VelianaCondor/Fluor-metro-de-bajo-costo-/Proyecto/Hito 2-Zona Procesamiento de Datos/Readme_Procesamiento_Task.md

## Aquí se verá el procesamiento de datos
## Tipos de protocolos de comunicación dentro del sistema embebido 
## La transmisión de datos (se evaluará si es con comunicación LORA o Wifi)
## El código del microcontrolador
## La interface de visualización
