VelianaCondor/Fluor-metro-de-bajo-costo-/Proyecto/Hito 2-Zona Procesamiento de Datos/Visualización en python-página web local/Diagrama de bloques .png

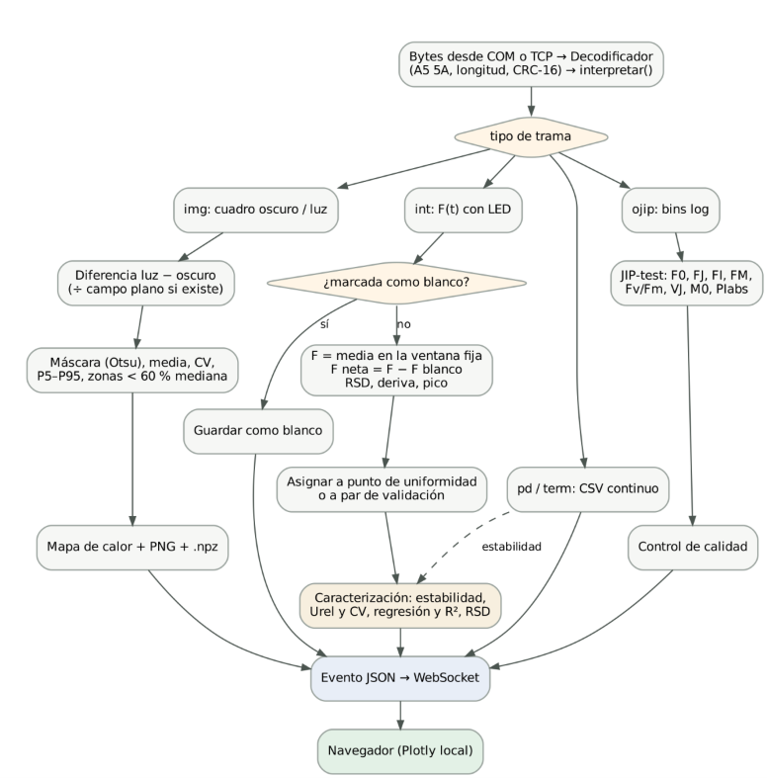
Proyecto/Hito 2-Zona Procesamiento de Datos/Visualización en python-página web local/Diagrama de bloques .png
