VelianaCondor/Fluor-metro-de-bajo-costo-/Proyecto/Hito 2/Area-optica/Diagrama-Bloques-Sistema-Optico.png

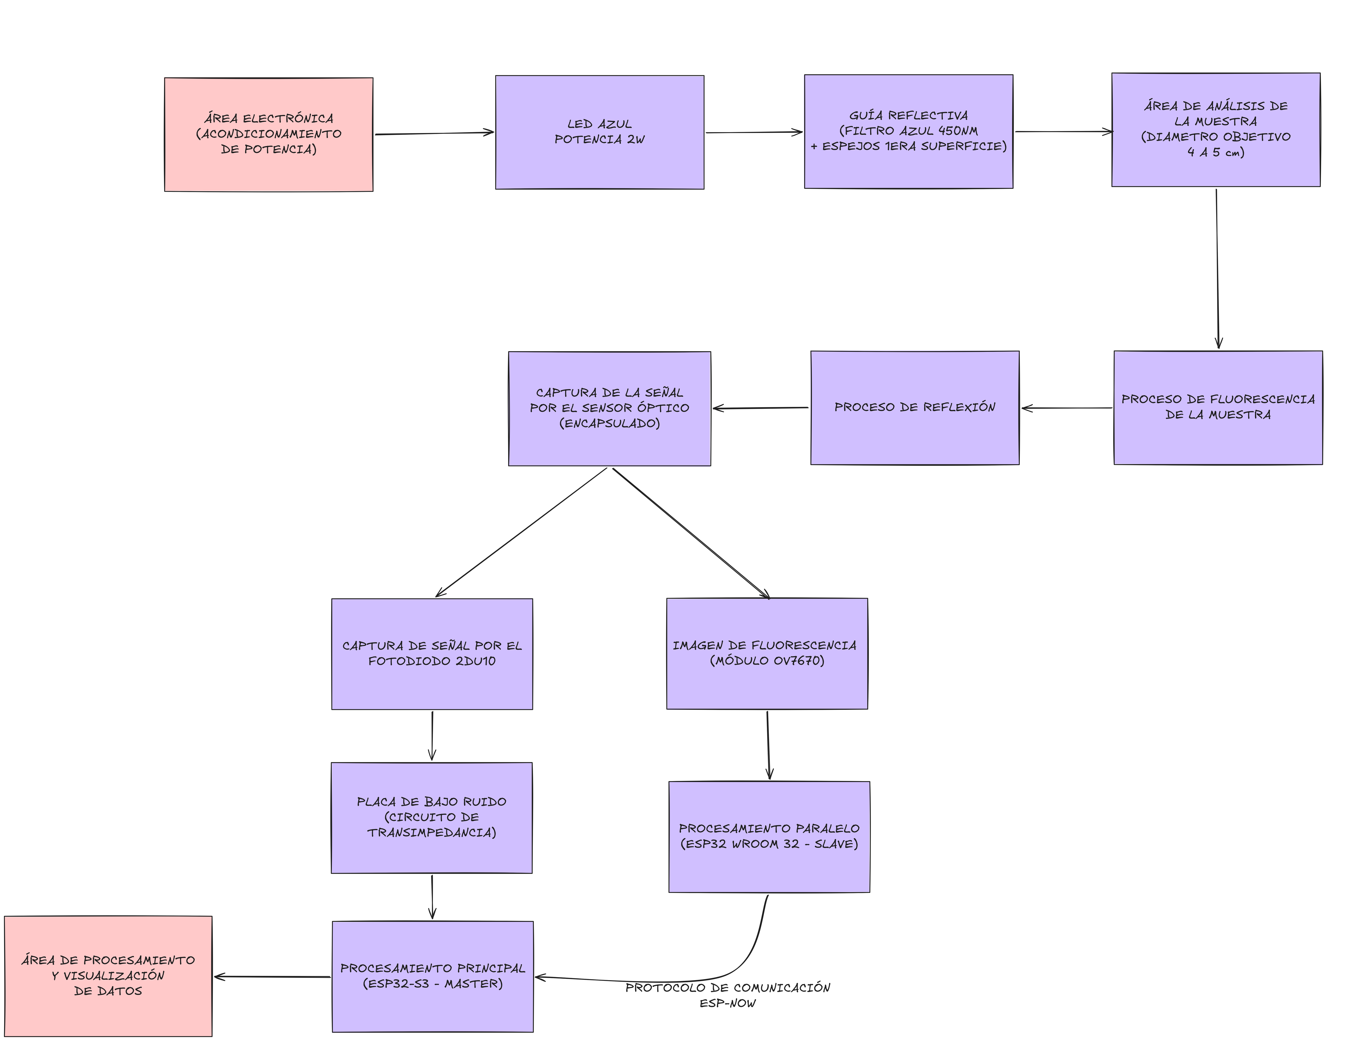
Proyecto/Hito 2/Area-optica/Diagrama-Bloques-Sistema-Optico.png
