VelianaCondor/Fluor-metro-de-bajo-costo-/Proyecto/Hito 2-Zona Procesamiento de Datos/Implementaciones preliminares (placa de bajo ruido-fotodiodo)/Data 2 fotodiodo placa.csv

No. | Date/Time | Function | Range | Value | Unit
1 | 2026-10-31 17:12:42 | DCV | 6 | 4.718 | V
2 | 2026-10-31 17:12:43 | DCV | 6 | 4.718 | V
3 | 2026-10-31 17:12:44 | DCV | 6 | 4.718 | V
4 | 2026-10-31 17:12:45 | DCV | 6 | 4.718 | V
5 | 2026-10-31 17:12:46 | DCV | 6 | 4.718 | V
6 | 2026-10-31 17:12:47 | DCV | 6 | 4.718 | V
7 | 2026-10-31 17:12:48 | DCV | 6 | 4.718 | V
8 | 2026-10-31 17:12:49 | DCV | 6 | 4.718 | V
9 | 2026-10-31 17:12:50 | DCV | 6 | 4.718 | V
10 | 2026-10-31 17:12:51 | DCV | 6 | 1.608 | V
11 | 2026-10-31 17:12:52 | DCV | 6 | 1.261 | V
12 | 2026-10-31 17:12:53 | DCV | 6 | 1.001 | V
13 | 2026-10-31 17:12:54 | DCV | 6 | 0.849 | V
14 | 2026-10-31 17:12:55 | DCV | 6 | 0.800 | V
15 | 2026-10-31 17:12:56 | DCV | 6 | 0.875 | V
16 | 2026-10-31 17:12:57 | DCV | 6 | 1.392 | V
17 | 2026-10-31 17:12:58 | DCV | 6 | 0.929 | V
18 | 2026-10-31 17:12:59 | DCV | 6 | 0.908 | V
19 | 2026-10-31 17:13:00 | DCV | 6 | 0.846 | V
20 | 2026-10-31 17:13:01 | DCV | 6 | 0.819 | V
21 | 2026-10-31 17:13:02 | DCV | 6 | 0.826 | V
22 | 2026-10-31 17:13:03 | DCV | 6 | 3.629 | V
23 | 2026-10-31 17:13:04 | DCV | 6 | 3.665 | V
24 | 2026-10-31 17:13:05 | DCV | 6 | 0.933 | V
25 | 2026-10-31 17:13:06 | DCV | 6 | 0.936 | V
26 | 2026-10-31 17:13:07 | DCV | 6 | 0.767 | V
27 | 2026-10-31 17:13:08 | DCV | 6 | 1.564 | V
28 | 2026-10-31 17:13:09 | DCV | 6 | 1.127 | V
29 | 2026-10-31 17:13:10 | DCV | 6 | 1.586 | V
30 | 2026-10-31 17:13:11 | DCV | 6 | 3.525 | V
31 | 2026-10-31 17:13:12 | DCV | 6 | 4.344 | V
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
177 | 2026-10-31 17:15:38 | DCV | 6 | -0.004 | V
178 | 2026-10-31 17:15:39 | DCV | 6 | -0.004 | V
179 | 2026-10-31 17:15:40 | DCV | 6 | -0.004 | V
180 | 2026-10-31 17:15:41 | DCV | 6 | -0.005 | V
181 | 2026-10-31 17:15:42 | DCV | 6 | -0.005 | V
182 | 2026-10-31 17:15:43 | DCV | 6 | -0.005 | V
