VelianaCondor/Fluor-metro-de-bajo-costo-/Proyecto/Hito 2 - Estructura/Ensamble Fluorometro.step

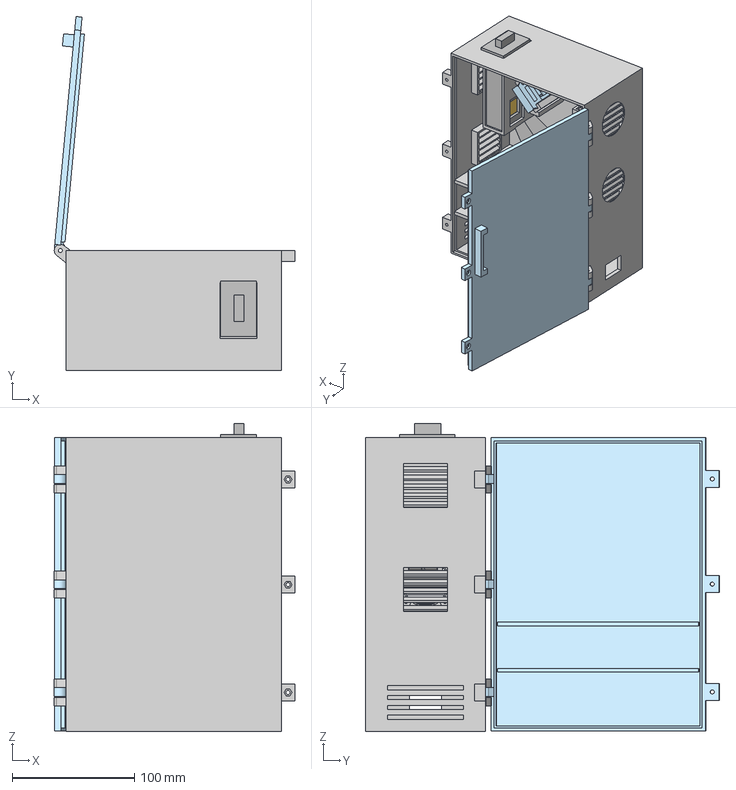
[picture p15: CAD file, 2026-11-01]
Proyecto/Hito 2 - Estructura/Ensamble Fluorometro.step
196.5 x 289.1 x 251.7 mm
