VelianaCondor/Fluor-metro-de-bajo-costo-/Proyecto/Hito 2 - Estructura/Prensa_Hoja_Flexible.step

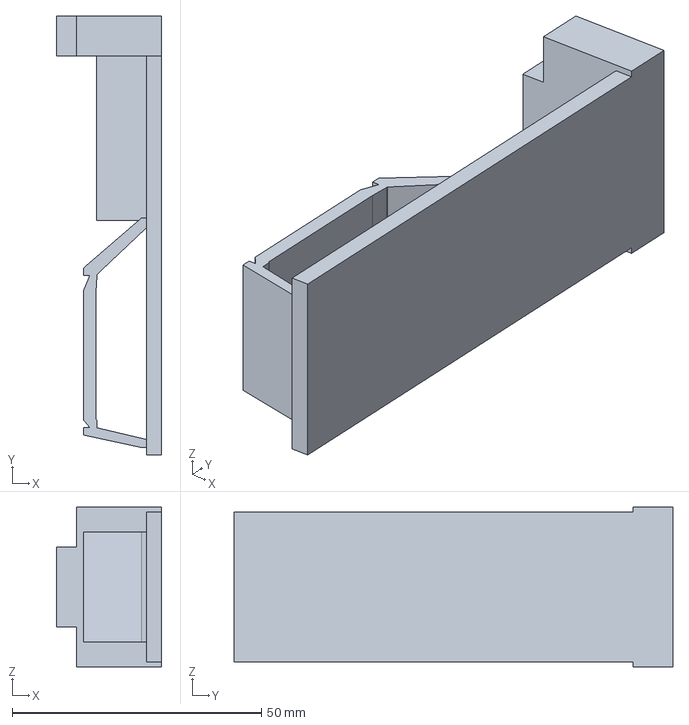
[picture p16: CAD file, 2026-11-01]
Proyecto/Hito 2 - Estructura/Prensa_Hoja_Flexible.step
21.0 x 88.0 x 32.0 mm
