VelianaCondor/Fluor-metro-de-bajo-costo-/Proyecto/Hito 2 - Estructura/Chasis_Torre.step

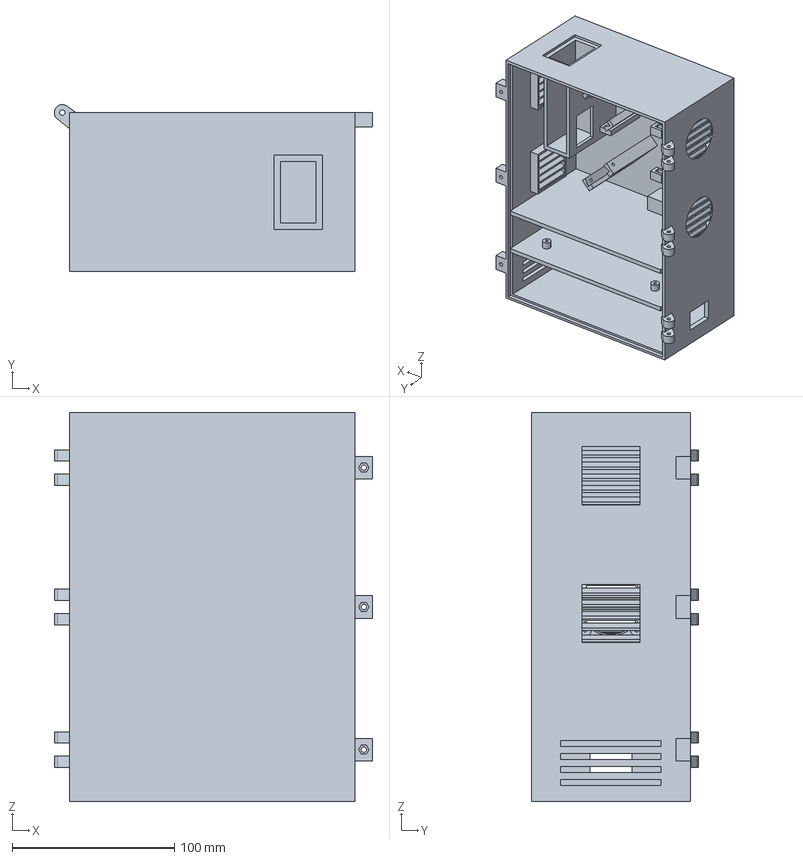
[picture p17: CAD file, 2026-11-01]
Proyecto/Hito 2 - Estructura/Chasis_Torre.step
196.5 x 103.0 x 240.0 mm
