VelianaCondor/Fluor-metro-de-bajo-costo-/Proyecto/Hito 2 - Estructura/Capsula_Vegetal.step

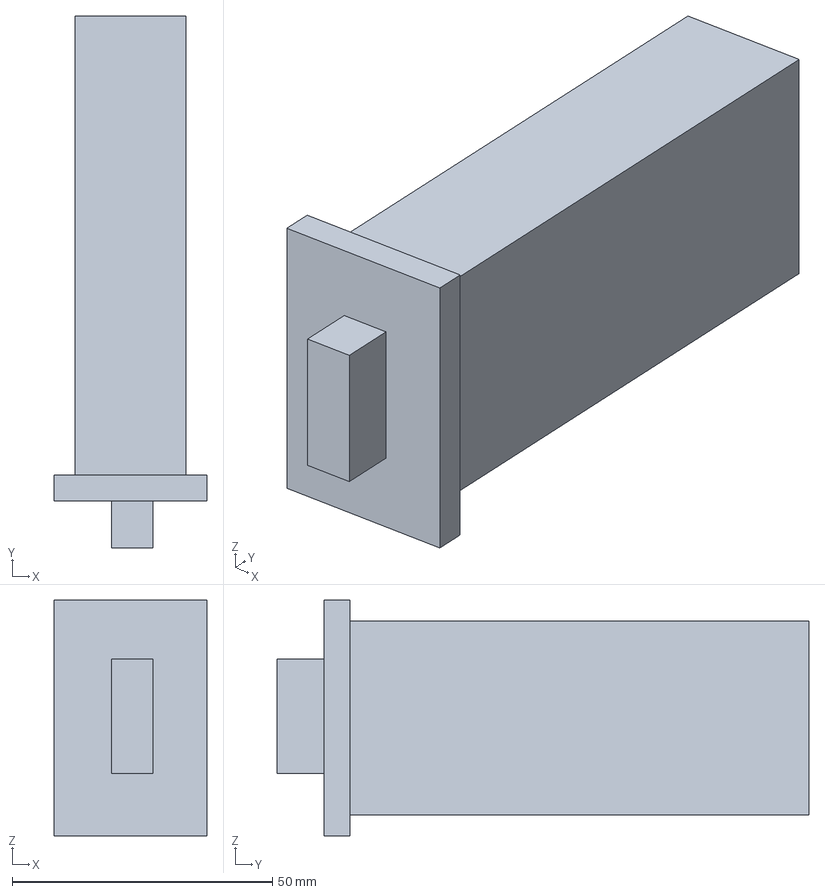
[picture p18: CAD file, 2026-11-01]
Proyecto/Hito 2 - Estructura/Capsula_Vegetal.step
29.3 x 102.2 x 45.3 mm
