VelianaCondor/Fluor-metro-de-bajo-costo-/Proyecto/Hito 2 - Estructura/Cartucho_Fotodiodo_Camara.step

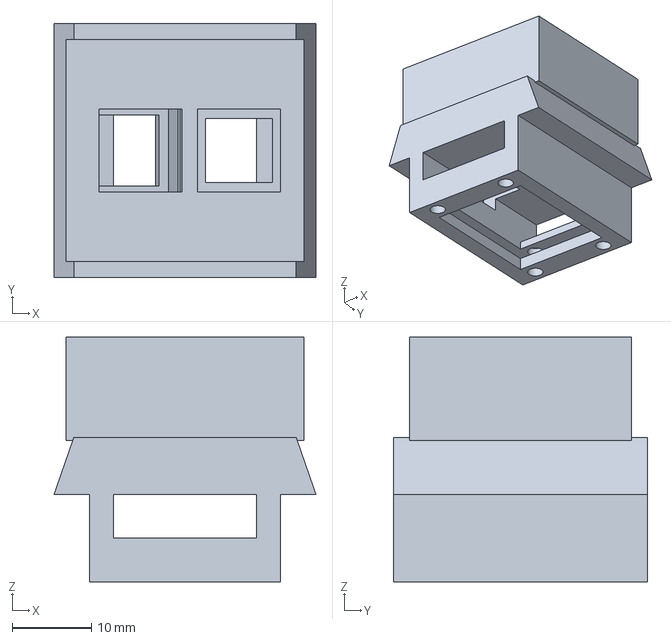
[picture p19: CAD file, 2026-11-01]
Proyecto/Hito 2 - Estructura/Cartucho_Fotodiodo_Camara.step
33.0 x 32.0 x 30.8 mm
