VelianaCondor/Fluor-metro-de-bajo-costo-/Proyecto/Hito 2 - Estructura/Cartucho_LED_Piramide.step

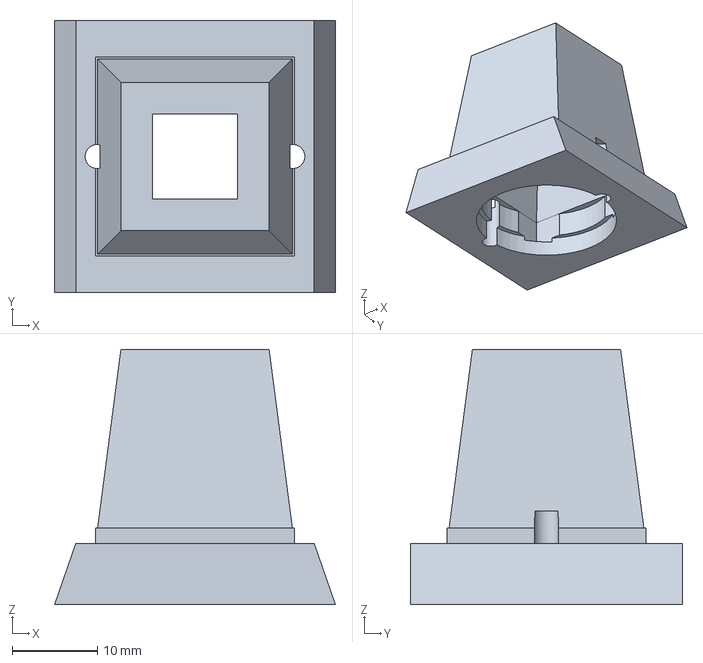
[picture p20: CAD file, 2026-11-01]
Proyecto/Hito 2 - Estructura/Cartucho_LED_Piramide.step
33.0 x 32.0 x 30.0 mm
