VelianaCondor/Fluor-metro-de-bajo-costo-/Proyecto/Hito 2 - Estructura/Puerta_Frontal.step

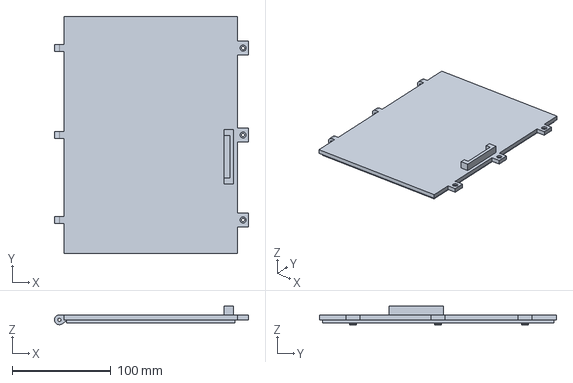
[picture p21: CAD file, 2026-11-01]
Proyecto/Hito 2 - Estructura/Puerta_Frontal.step
196.5 x 240.0 x 18.8 mm
