VelianaCondor/Fluor-metro-de-bajo-costo-/Proyecto/Hito 2 - Estructura/Ensamble Fluorometro Cotas.pdf

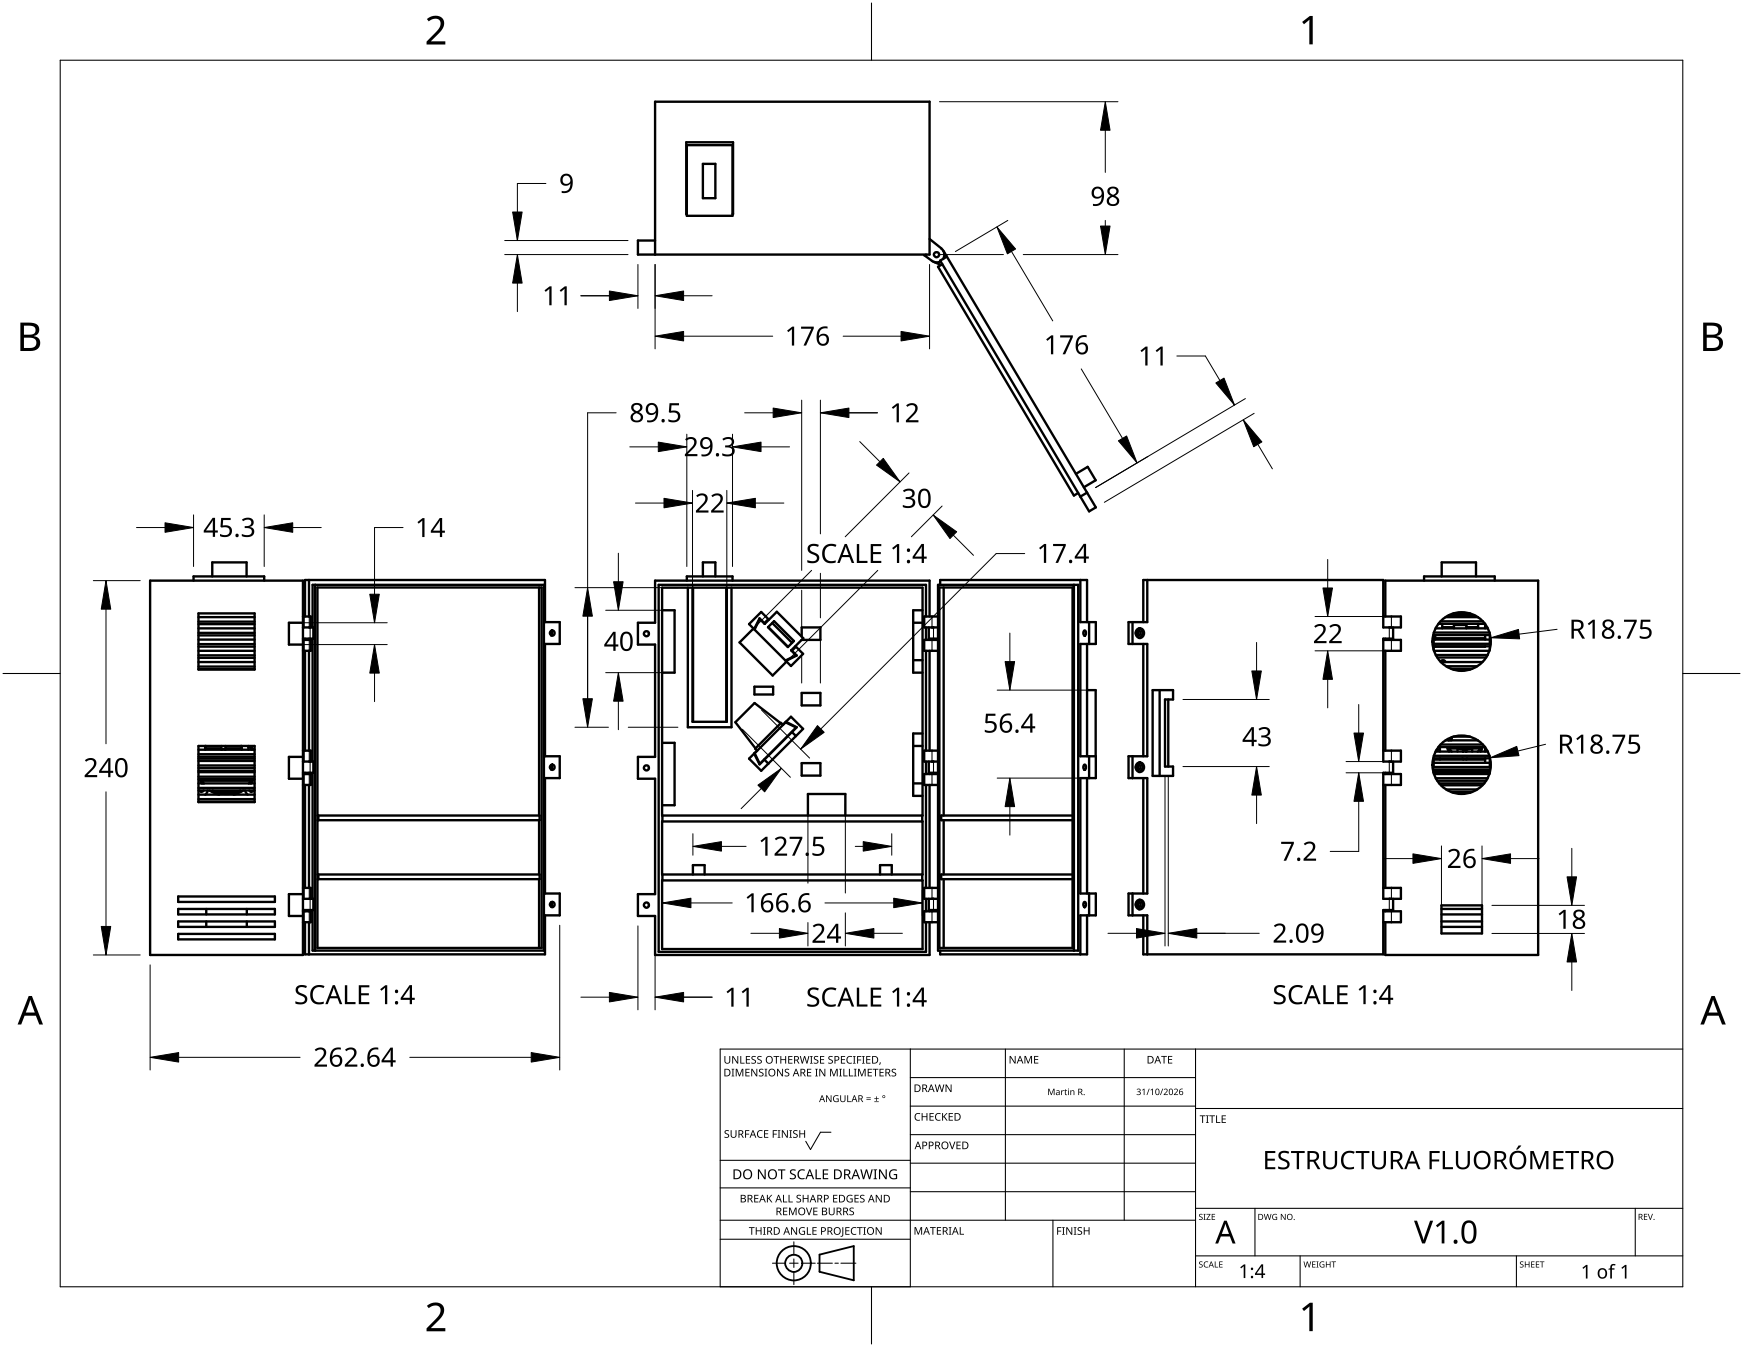
[picture p22: page 1]
