VelianaCondor/Fluor-metro-de-bajo-costo-/(commit log)

2026-10-04 Agregamos las fotos de los integrantes del equipo
2026-10-04 Actualización de foto
2026-10-04 Cambios posteriores al de José
2026-10-05 Foto en la lista de miembros
2026-10-14 Avance de cada area respetiva, por mi parte, referente al diseno optico
2026-10-15 Create Tareas para esta área Procesamiento
2026-10-15 Rename Tareas para esta área to Tareas para esta área.md
2026-10-15 Creando la carpeta de procesamiento y tareas
2026-11-01 Add files via upload
    Área estructura, modelos CAD y ensamble.
    [Capsula_Vegetal.step, Cartucho_Fotodiodo_Camara.step, Cartucho_LED_Piramide.step, Chasis_Torre.step, Ensamble Fluorometro.step, Prensa_Hoja_Flexible.step, Puerta_Frontal.step]
2026-11-01 Rename Proyecto/Hito 2-Zona Procesamiento de Datos/resumen_fotodiodo_esp32s3.md to Proyecto/Hito 2-Zona Procesamiento de Datos/Implementaciones preliminares (placa de bajo ruido-fotodiodo/resumen_fot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
2026-11-01 Add files via upload
    Esta fue la data final medida por el multímetro para tener en cuenta el tratamiento del fotodiodo.
    [Data 2 fotodiodo placa.csv]
2026-11-01 Rename Proyecto/Hito 2-Zona Procesamiento de Datos/Implementaciones preliminares (placa de bajo ruido-fotodiodo/Data 2 fotodiodo placa.csv to Proyecto/Hito 2-Zona Procesamiento de Datos/Implementacio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
2026-11-01 Add files via upload
    Data final medida con el multímetro para el código final
    [Data 2 fotodiodo placa.csv]
2026-11-01 Add files via upload
    El código empleado final para analizar los niveles de salida de la placa de bajo ruido al esp32 s3
2026-11-01 Se comparte el desarrollo del area Optica, desde su esquematico, su diagrama de bloques hasta el cambio de componentes implementandos.
2026-11-01 Rename Proyecto/Hito 2-Zona Procesamiento de Datos/LEEME.md to Proyecto/Hito 2-Zona Procesamiento de Datos/Visualización en python-página web local/Descripción.md
2026-11-01 Rename Proyecto/Hito 2-Zona Procesamiento de Datos/Visualización en python-página web local/simulador_s3.py to Proyecto/Hito 2-Zona Procesamiento de Datos/Visualización en python-página web local/APP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
2026-11-01 Rename Proyecto/Hito 2-Zona Procesamiento de Datos/Visualización en python-página web local/APP PC/.gitkeep to Proyecto/Hito 2-Zona Procesamiento de Datos/Visualización en python-página web local/APP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
2026-11-01 Rename Proyecto/Hito 2-Zona Procesamiento de Datos/Visualización en python-página web local/APP PC/index.html to Proyecto/Hito 2-Zona Procesamiento de Datos/Visualización en python-página web local/A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
